sobociakk/CD4011B-CMOS-180nm-Layout/README.md

# CD4011B-CMOS-180nm-Custom-Layout

## Overview
This repository contains a full-custom physical design of a CD4011B equivalent integrated circuit. The project was developed from schematic entry down to the physical layout and post-layout verification as part of an academic project

*Note: Due to NDA restrictions, proprietary TSMC technology files are not included. This repository serves as a portfolio showcase of the design methodology, layout structures, and simulation results.*

## Technology & Tools
* **Process Node:** CMOS TSMC 180 nm 1P6M 1.8V
* **Layout & DRC:** Magic VLSI
* **Simulation:** LTSpice (Pre-layout and Post-layout parasitic extraction)

## Key Design Features
The layout includes physical protections required for reliable chip fabrication:
* **ESD Protection:** Implemented robust protection on all I/O and power pads.
* **Reliability:** Strict layout rules applied to prevent Latch-up and Electromigration.
* **I/O PADs:** Custom 60x70 µm pads designed with the "no-devices-under-pad" rule utilizing all available metal layers.

## Performance Specs
The scaled output buffers were rigorously verified across the following conditions:
* **Operating Voltage:** $V_{DD}$ = 1.8V ± 10%
* **Temperature Range:** -30°C to +125°C
* **Capacitive Load:** 25 pF

## IC diagram [^1]
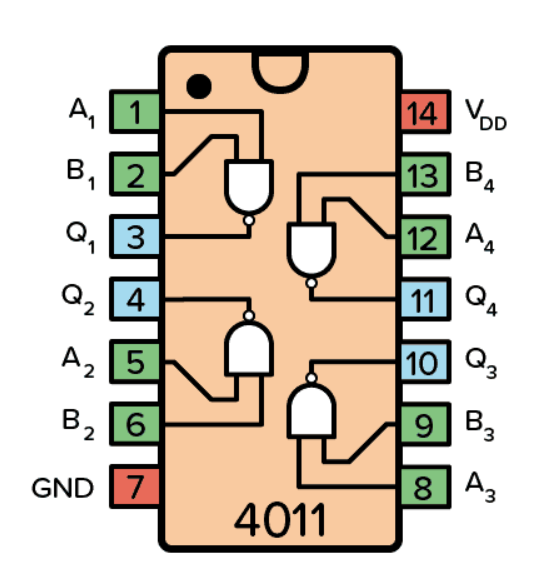
[picture p1: cd4011b/img/ic_diagram.png]
ic_diagram


## Proposed layout schematic [^2] and pre-extraction netlist
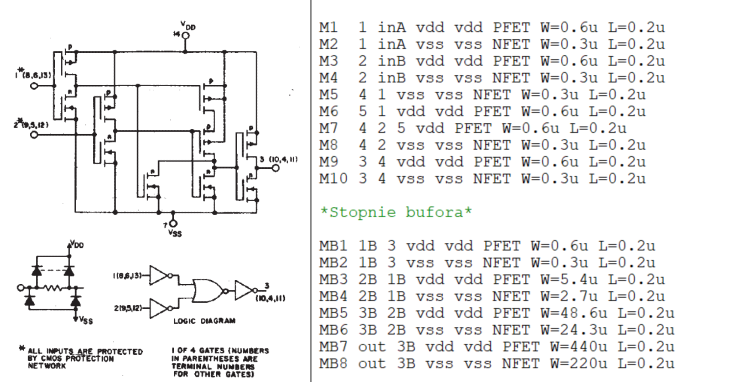
[picture p2: cd4011b/img/schem_netlist.png]
schem_netlist

## Pre-extraction Waveforms & Verification

### Output buffer current drive capability
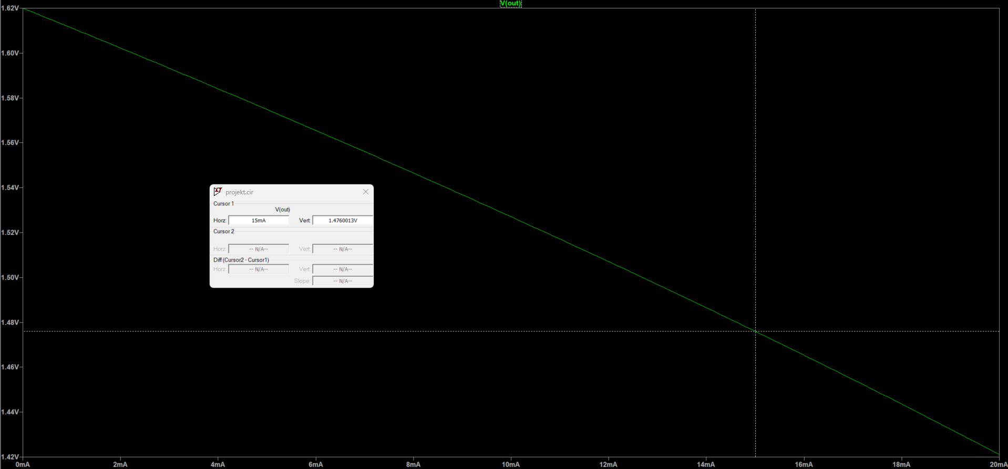
[picture p3: cd4011b/img/cdc_vh.png]
cdc_vh

*At a current load of 15mA, with Vdd –10% and a maximum temperature of 125°C, the output high voltage drops to 1.476V.*
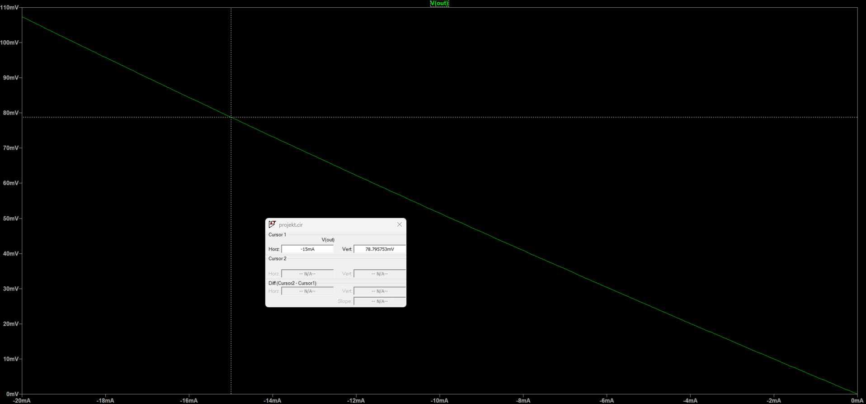
[picture p4: cd4011b/img/cdc_vl.png]
cdc_vl

*At a current load of 15mA, Vdd –10% and a maximum temperature of 125°C, the output low voltage drops to 78.795 mV.*

### Signal rise and fall time
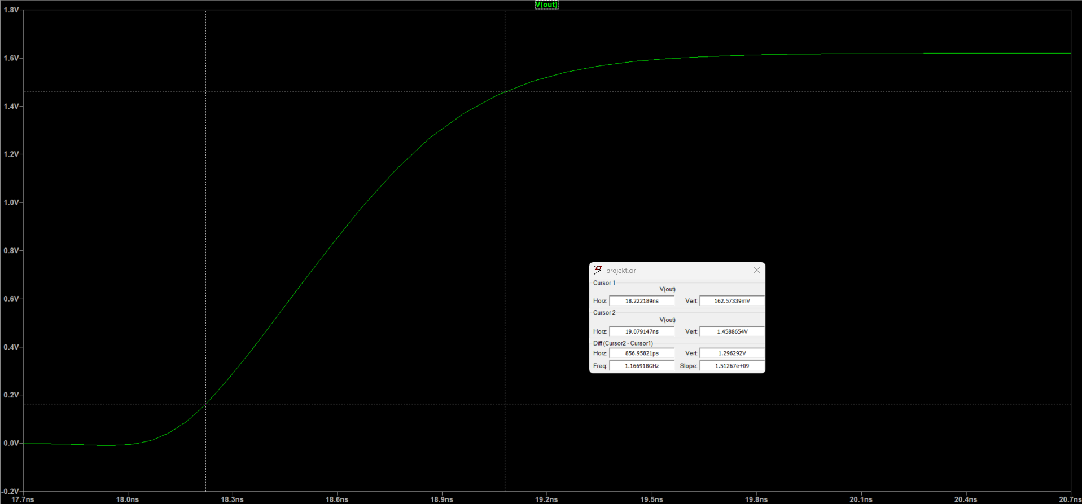
[picture p5: cd4011b/img/s_rise.png]
s_rise

*The rise time is 0.86 ns.*
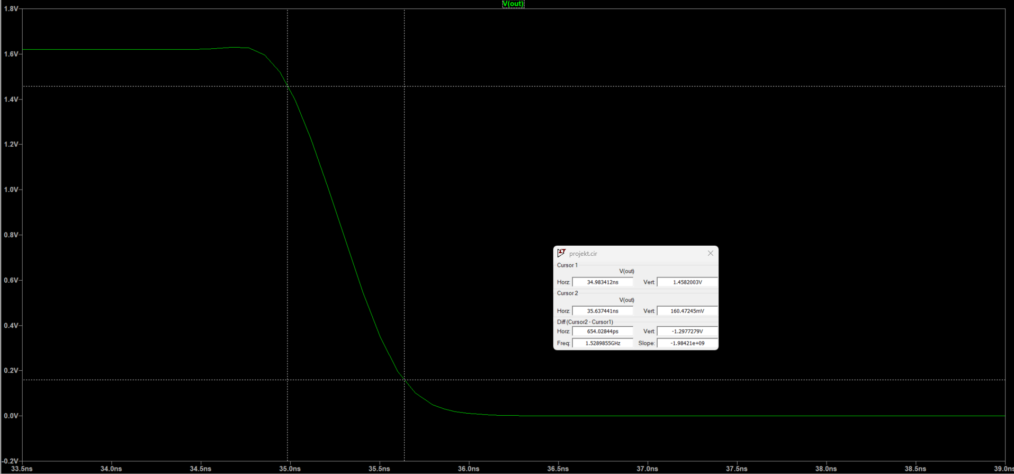
[picture p6: cd4011b/img/s_fall.png]
s_fall

*The fall time is 0.65 ns.*

### Threshold voltage
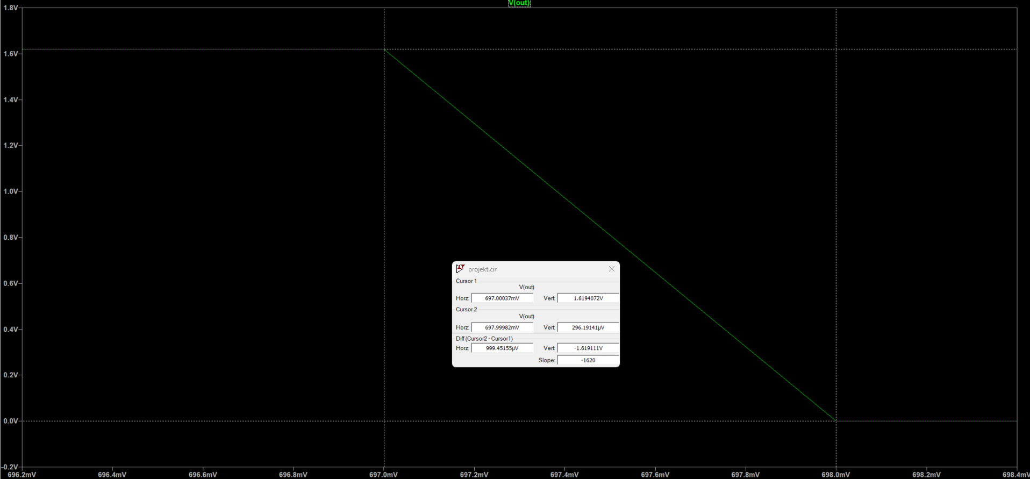
[picture p7: cd4011b/img/th_voltage.png]
th_voltage

*The threshold voltage is 697 mV.*

### DC current consumption
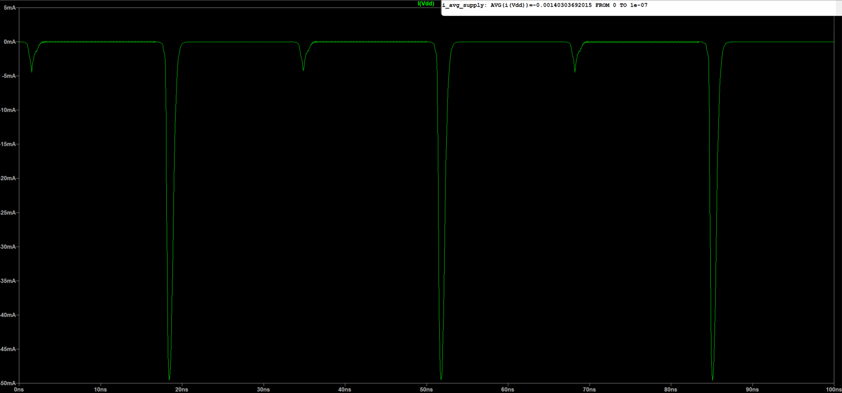
[picture p8: cd4011b/img/idd_cons.png]
idd_cons

*Averge DC current consumption is 1.40 mA, with a peak of 50 mA.*

## Single gate layout
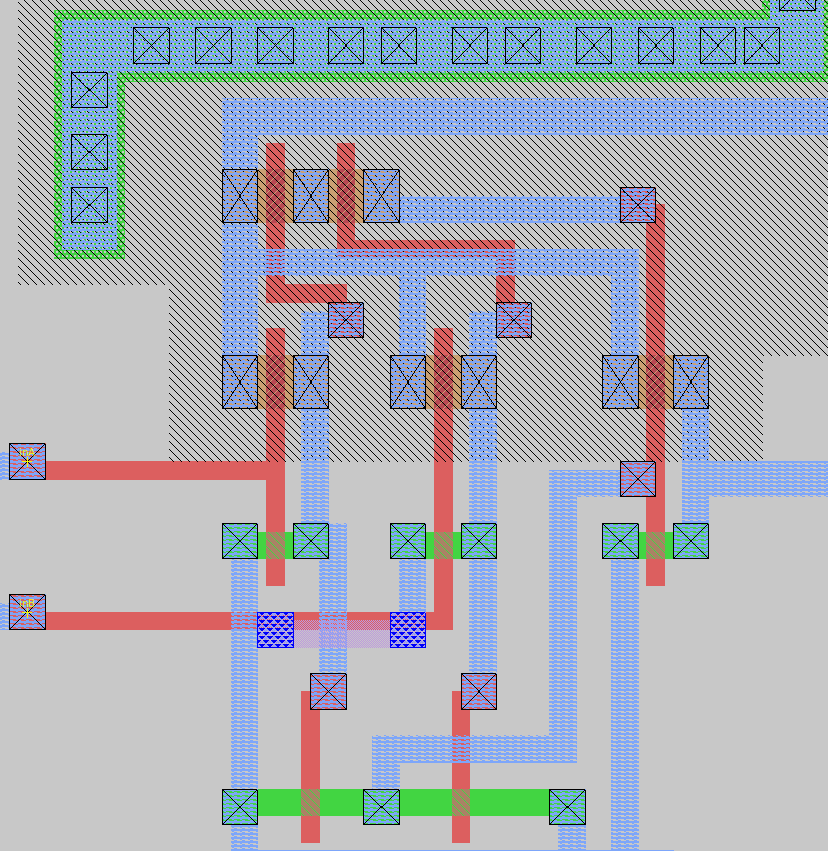
[picture p9: cd4011b/img/gate_lay.png]
gate_lay


## Gate with buffer stages
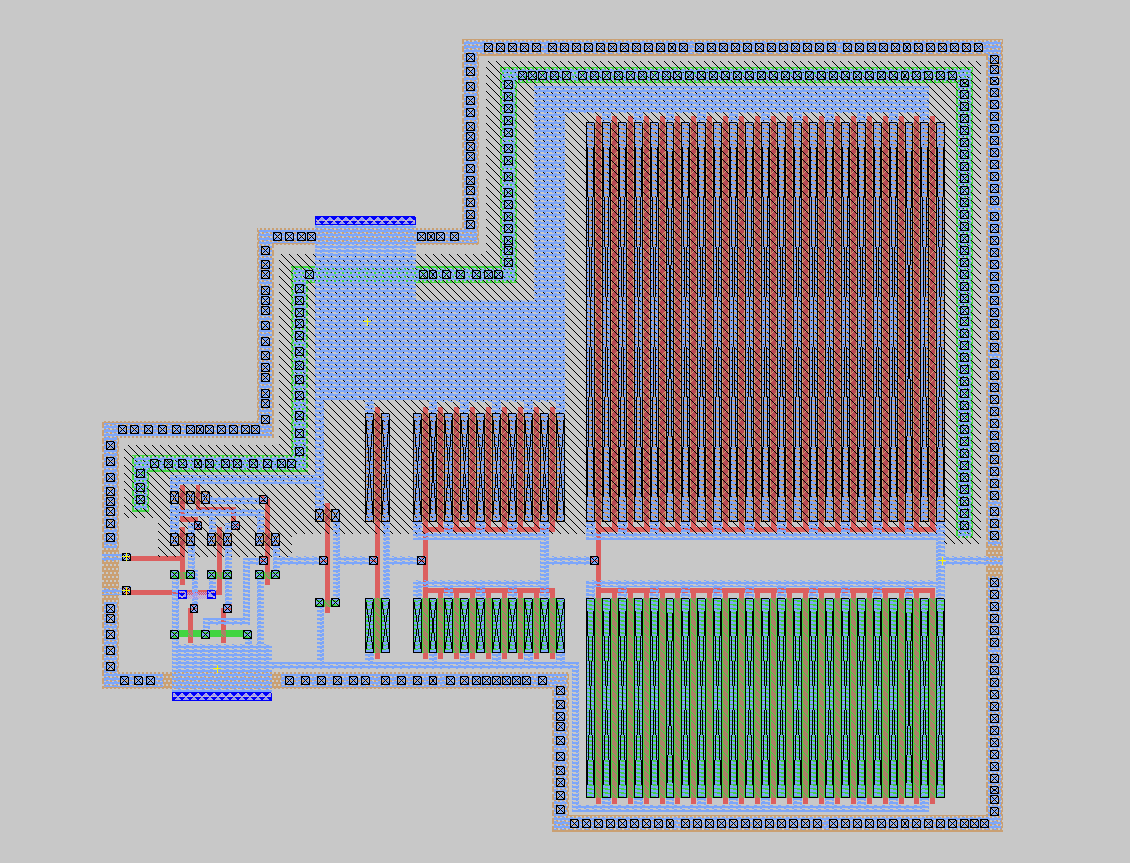
[picture p10: cd4011b/img/gateb_lay.png]
gateb_lay


## ESD protection + Pad
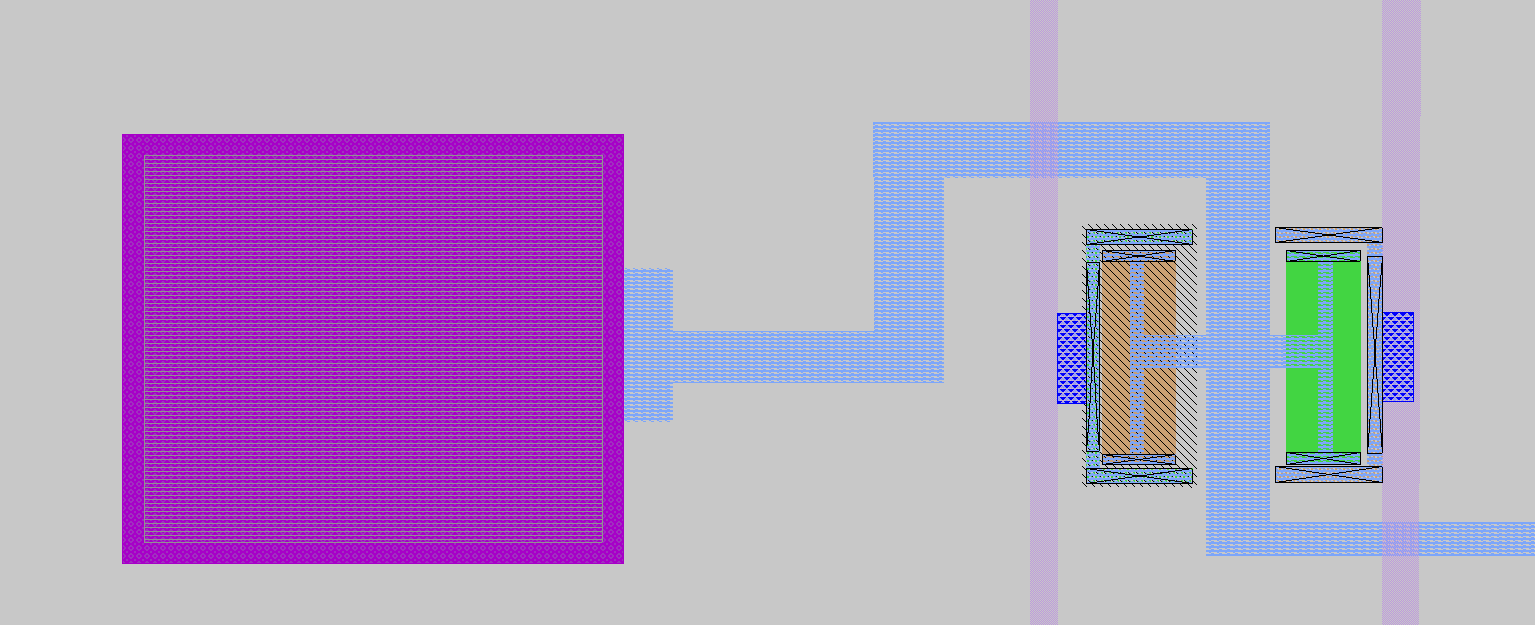
[picture p11: cd4011b/img/esd_pad.png]
esd_pad


## Layout topography
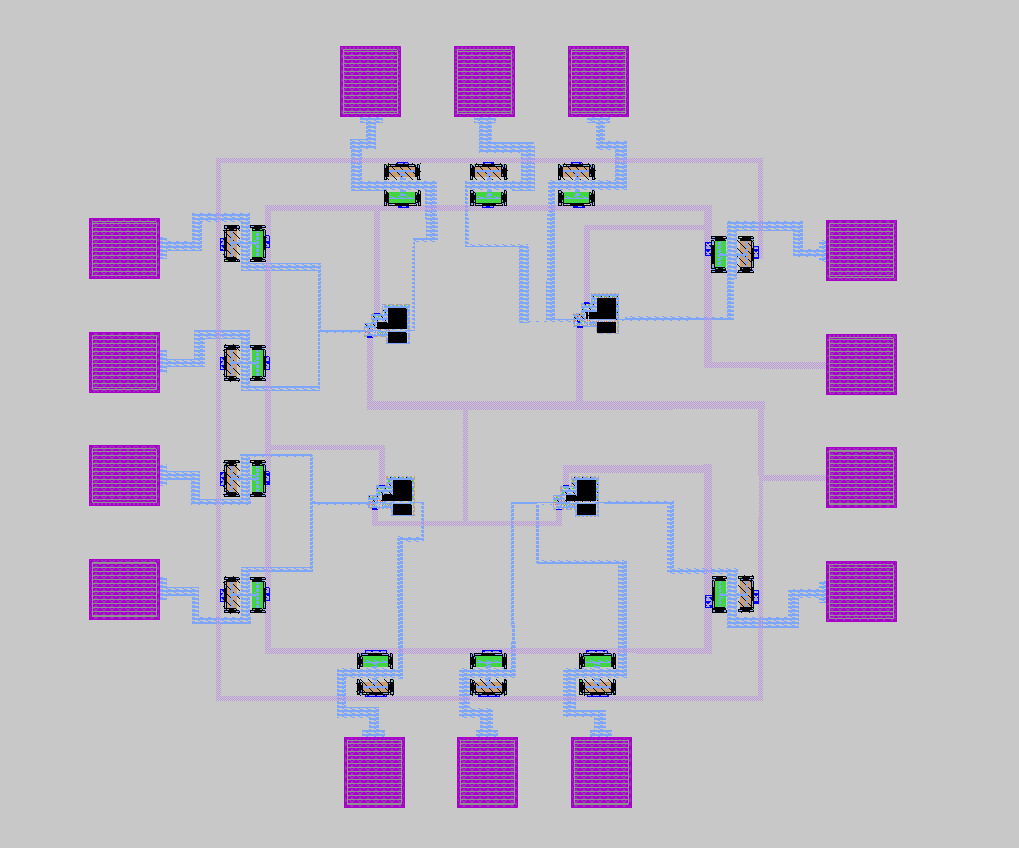
[picture p12: cd4011b/img/layout.png]
layout


## Post-extraction Waveforms & Verification

### Post-extraction Output buffer current drive capability
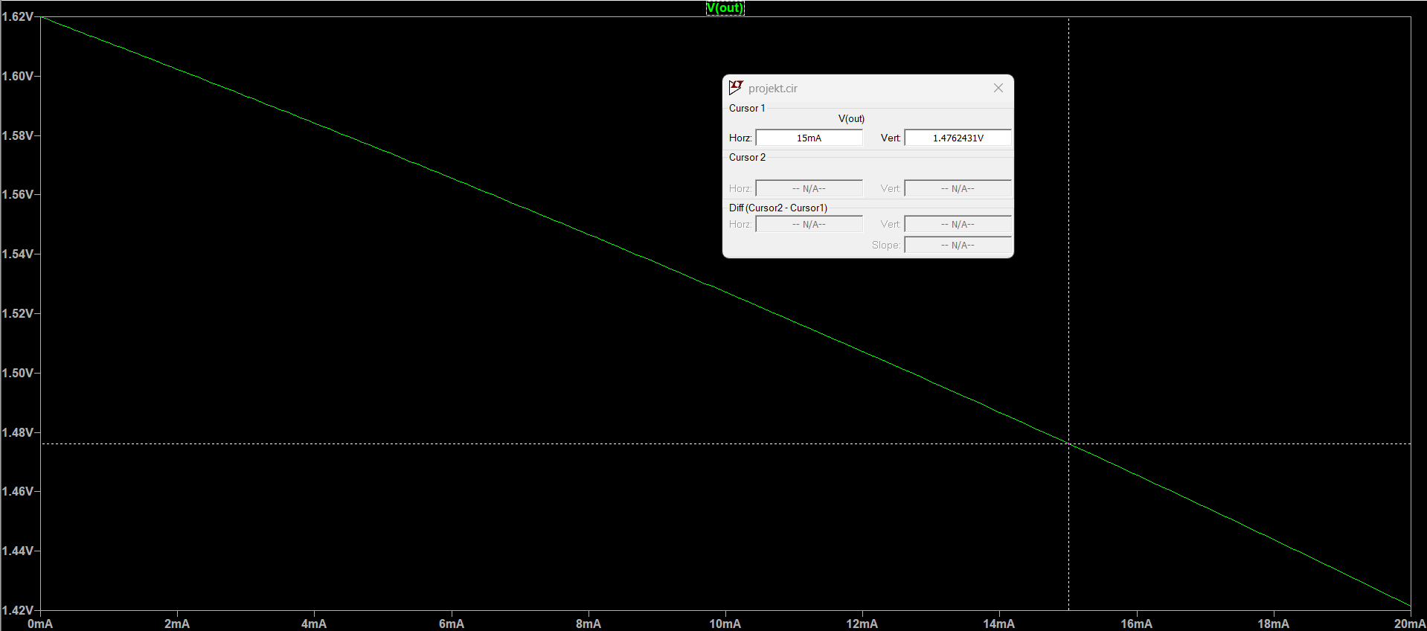
[picture p13: cd4011b/img/cdc_vh_pe.png]
cdc_vh_pe

*At a current load of 15mA, with Vdd –10% and a maximum temperature of 125°C, the output high voltage drops to 1.476V.*
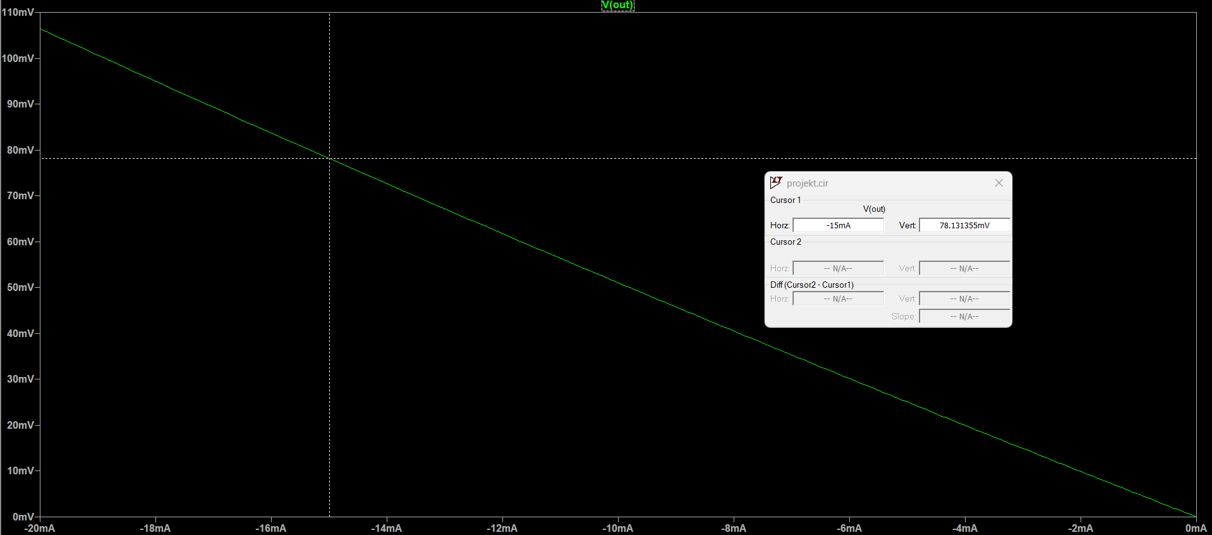
[picture p14: cd4011b/img/cdc_vl_pe.png]
cdc_vl_pe

*At a current load of 15mA, Vdd –10% and a maximum temperature of 125°C, the output low voltage drops to 78.131 mV.*

### Post-extraction Signal rise and fall time
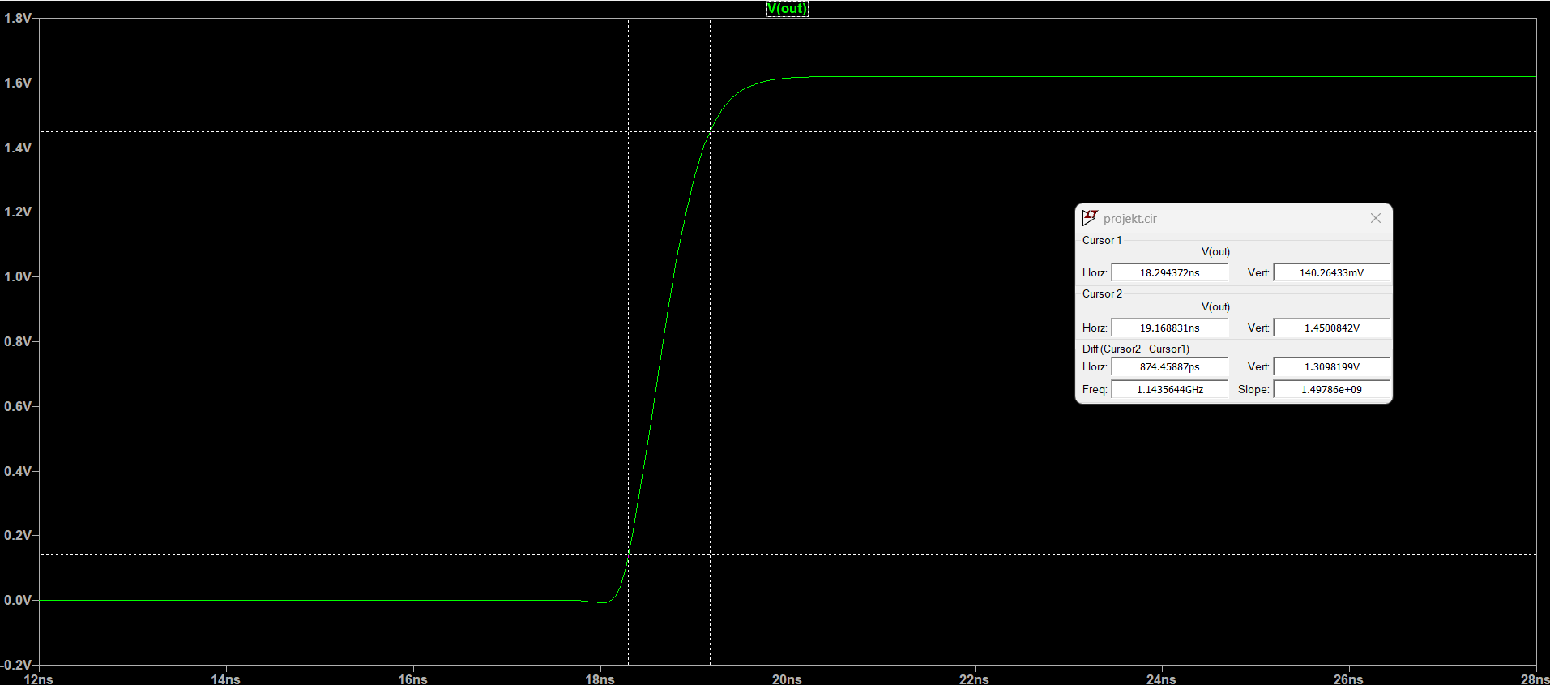
[picture p15: cd4011b/img/s_rise_pe.png]
s_rise_pe

*The rise time is 0.87 ns.*
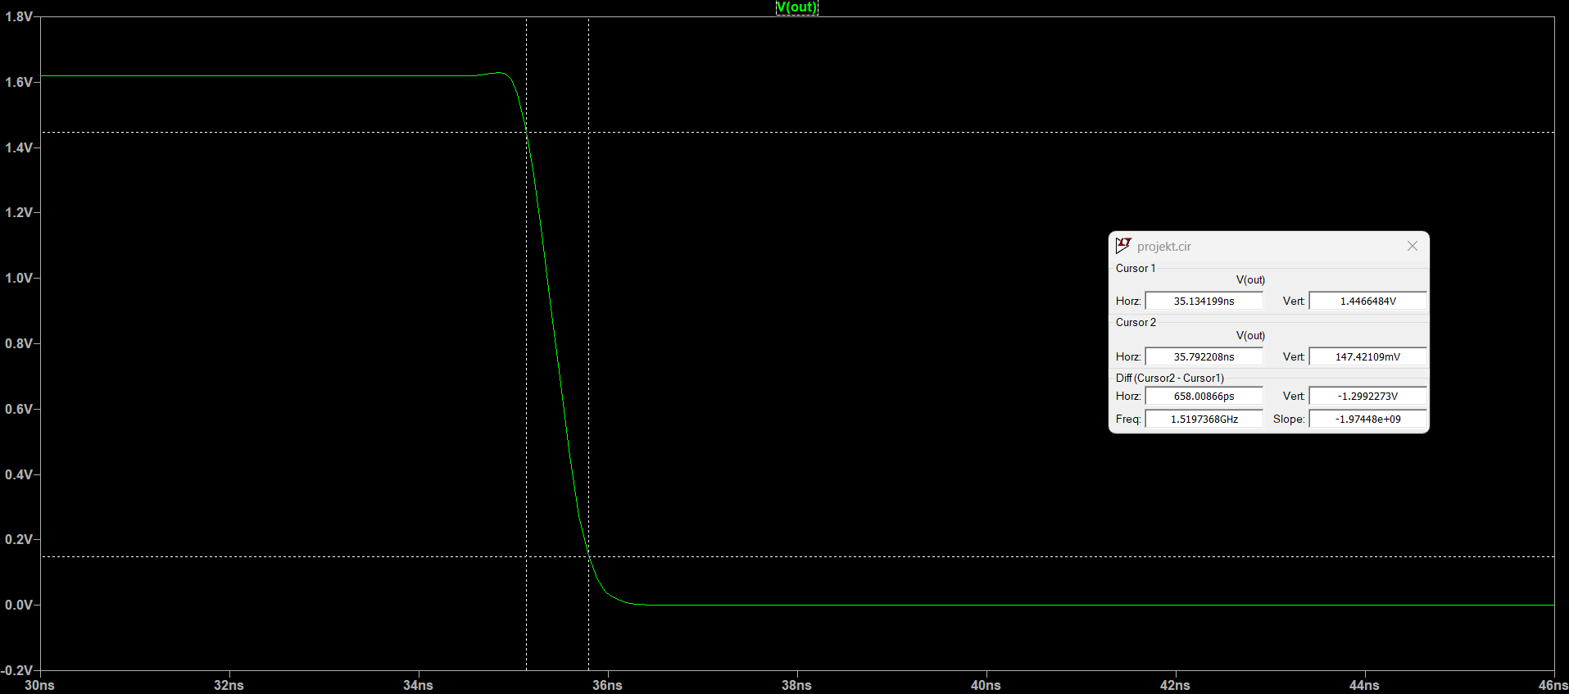
[picture p16: cd4011b/img/s_fall_pe.png]
s_fall_pe

*The fall time is 0.65 ns.*

### Post-extraction Threshold voltage
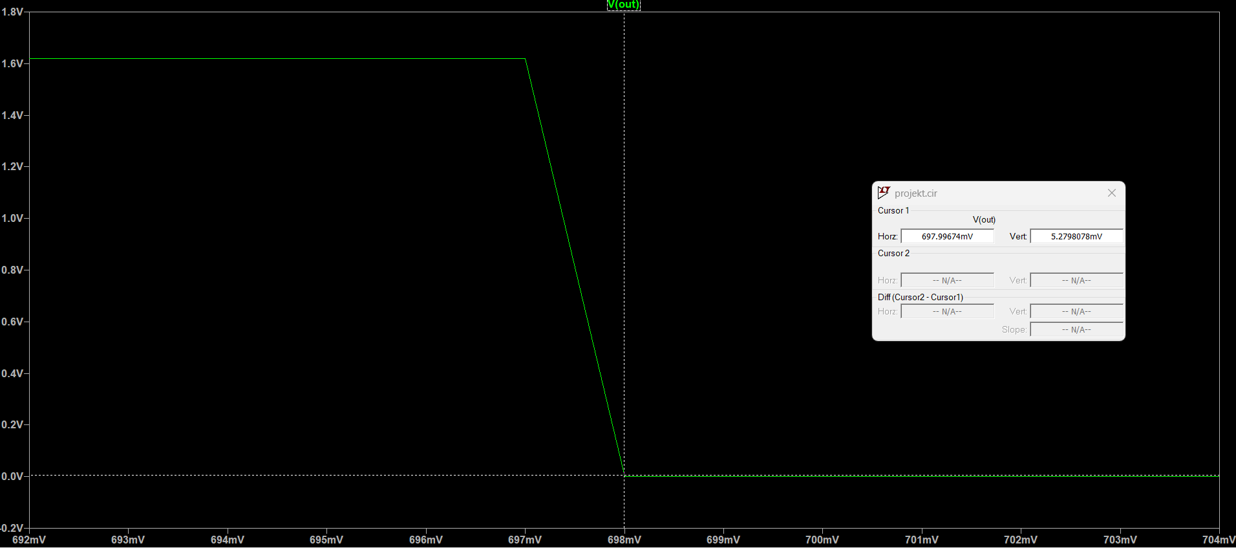
[picture p17: cd4011b/img/th_voltage_pe.png]
th_voltage_pe

*The threshold voltage is 697 mV.*

## Results Summary
The following table compares the theoretical requirements with the LTSpice simulation results, both pre-layout and post-layout.

| Parameter | Target | Pre-Layout | Post-Layout |
| :--- | :--- | :--- | :--- |
| **Max Frequency** | $\ge$ 30 MHz | 30.00 MHz | 29.948 MHz |
| **Output Voltage High (15 mA load)** | $\ge$ 1.62 V (90% VDD) | 1.476 V | 1.476 V |
| **Output Voltage Low (15 mA load)** | $\le$ 0.18 V (10% VDD) | 78.795 mV | 78.131 mV |
| **Rise Time** | - | 0.856 ns | 0.87 ns |
| **Fall Time** | - | 0.649 ns | 0.656 ns |
| **Switching Voltage** | ~900 mV | 697 mV | 696 mV |

*Average power supply current consumption was measured at 1.40 mA with a peak of 50 mA.*

## Summary
The designed circuit has been optimized for the required temperature range, ensuring correct operation across the entire specified interval. At a minimum input signal frequency of 30 MHz, the output yields valid values. The design incorporates Electrostatic Discharge (ESD) protection on the inputs, and narrow spacing has been maintained between adjacent leads, islands, and the substrate to protect the circuit from the latch-up effect. Output pads measuring 60 × 70 µm are located in the pad layer around the perimeter of the structure. The system operates stably at a supply voltage of 1.8 V under the assumed load.

## Repository Contents
* `layout/` - Magic VLSI layouts
* `img/` - Screenshots of waveforms and layouts
* `sim/` - Layout simulations in LTspice

## References
[^1]: https://www.ti.com/lit/ds/symlink/cd4011b.pdf?ts=1772251161710&ref_url=https%253A%252F%252Fwww.google.com%252F

[^2]: https://www.build-electronic-circuits.com/4000-series-integrated-circuits/ic-4011/
